xiang-wang-US/Combat_Robot/docs/Combat_Robot_Case_Study.pdf

Context

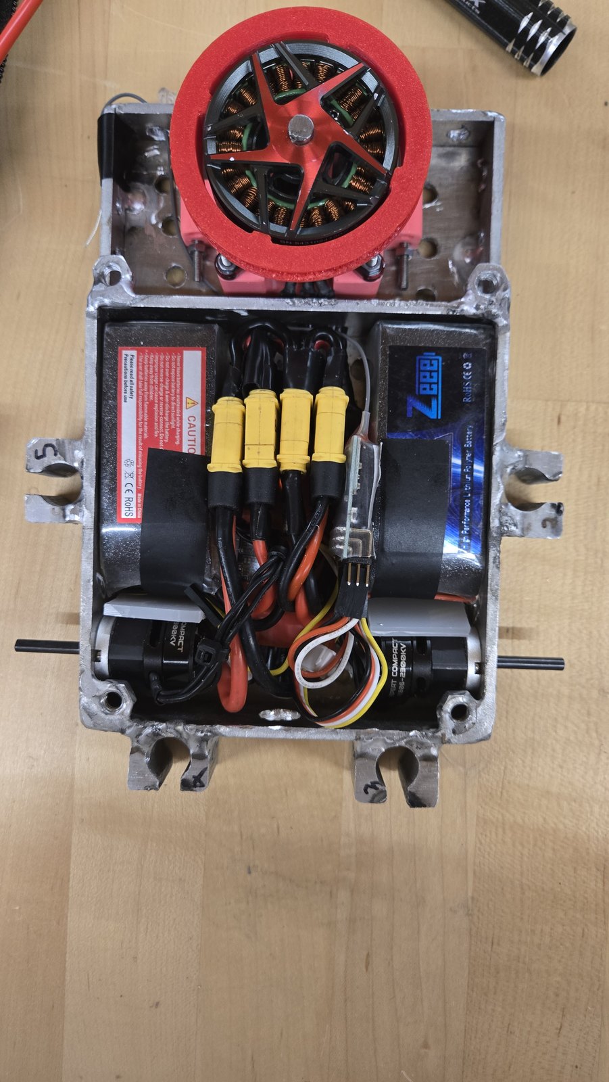
[picture p13: figure]

ASME combat robotics team, Cntrl Alt Defeat

Dates
Fall 2025 to April 2026

My role
Electrical subsystem lead

Scope
Power, motor control, radio,

weapon and chassis analysis

Tools
SolidWorks mass properties,

Desmos, wiring design

Outcome
2nd of 16 teams

# 6 lb Combat Robot

Electrical lead for a 6 lb spinner that placed 2nd

of 16 teams. Power, motor control, radio, and the

analysis behind the weapon and chassis.

I owned the electrical system of a 6 lb combat robot:

battery architecture, weapon and drive motor control,

radio, and the harness. I also wrote the two analyses

that shaped the weapon and the chassis: an energy

based speed requirement for the weapon motor and

an assessment that ruled out an all TPU chassis. The

robot placed 2nd of 16.

2nd

of 16 teams
22.2 V

weapon bus from two 3S packs in series

## about 6,000 rpm

weapon speed needed for 500 J

Project

### 6 lb Combat Robot

Sheet title
Overview

Engineer
Xiang Wang

Date
2025 to 2026

Sheet

# Electrical architecture

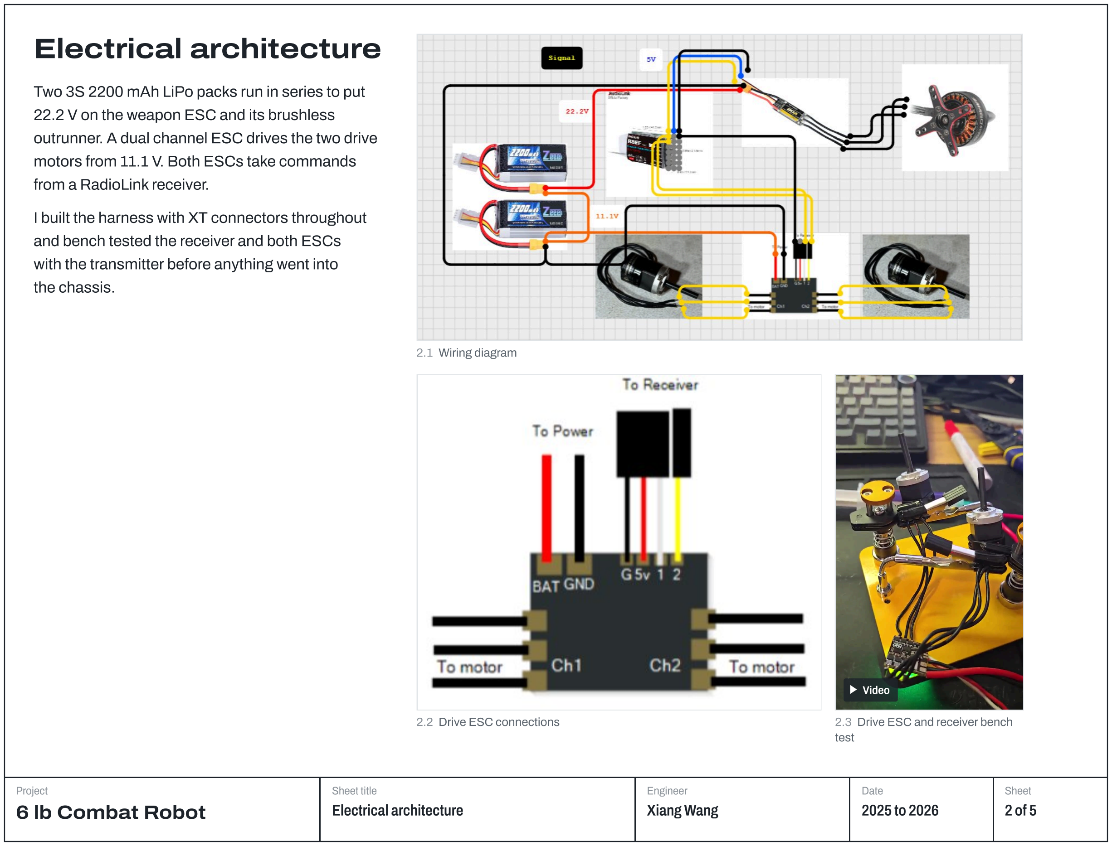
[picture p14: page 2]

Two 3S 2200 mAh LiPo packs run in series to put

22.2 V on the weapon ESC and its brushless

outrunner. A dual channel ESC drives the two drive

motors from 11.1 V. Both ESCs take commands

from a RadioLink receiver.

I built the harness with XT connectors throughout

and bench tested the receiver and both ESCs

with the transmitter before anything went into

the chassis.

2.1 Wiring diagram

2.2 Drive ESC connections | 2.3 Drive ESC and receiver bench
| test

Project

Sheet title
Electrical architecture

Engineer
Date

Sheet

Video (https://github.com/xiang-wang-US/Combat_Robot/blob/main/media/video/bot_esc_test.mp4)

# Weapon speed requirement

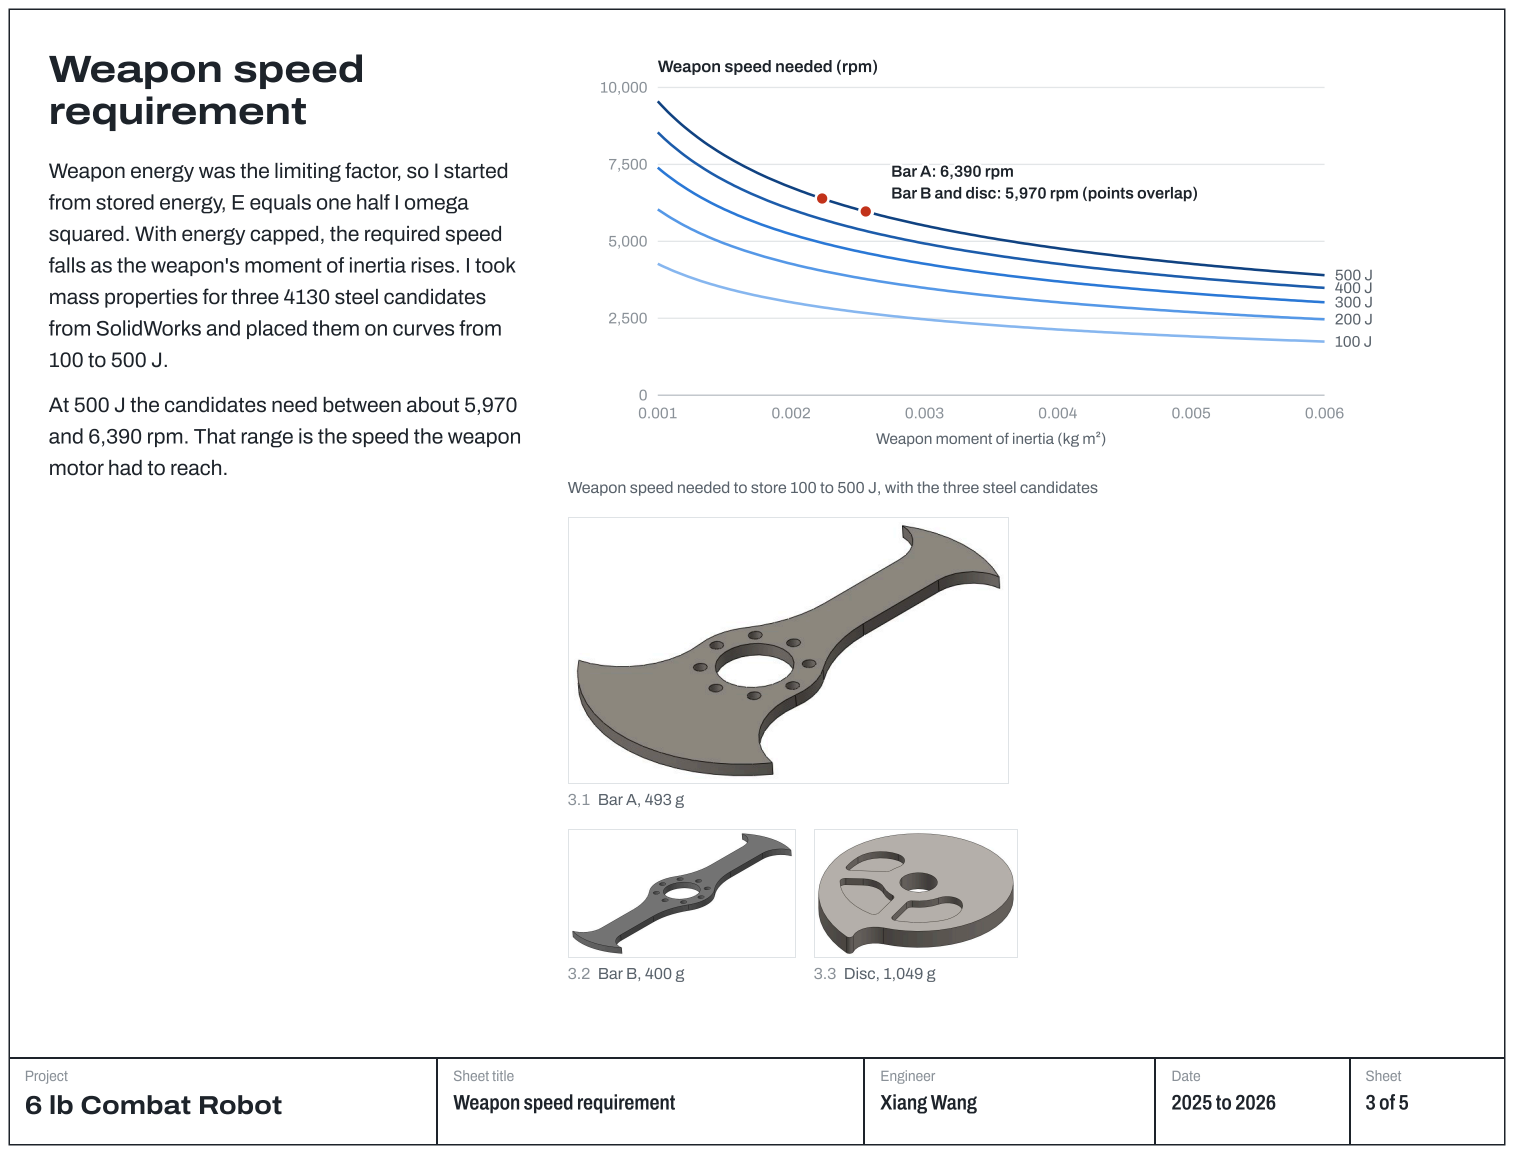
[picture p15: page 3]
3.1 Bar A, 493 g; 3.2 Bar B, 400 g; 3.3 Disc, 1,049 g; Project; Engineer; Date; Sheet

Weapon speed needed (rpm)

Weapon energy was the limiting factor, so I started

Bar A: 6,390 rpm

from stored energy, E equals one half I omega

Bar B and disc: 5,970 rpm (points overlap)

squared. With energy capped, the required speed

falls as the weapon's moment of inertia rises. I took

mass properties for three 4130 steel candidates

from SolidWorks and placed them on curves from

At 500 J the candidates need between about 5,970

and 6,390 rpm. That range is the speed the weapon

Weapon moment of inertia (kg m²)

motor had to reach.

Weapon speed needed to store 100 to 500 J, with the three steel candidates

Sheet title
Weapon speed requirement

# Chassis material assessment

A TPU only chassis was proposed for its impact

absorption. I wrote an assessment arguing against

it. TPU's modulus is roughly 10 to 100 MPa against

about 70 GPa for aluminum, so a TPU frame flexes

enough to misalign shafts and weapon mounts. It

also creeps under sustained load, lets threaded

inserts pull out under shock, and softens near 80 to

100 C, which motors and ESCs can reach.

The recommendation was a rigid structure with TPU

only where it helps: bumpers, electronics mounts,

and abrasion covers. The final robot used an

aluminum chassis.


4.1 Aluminum chassis during fabrication | 4.2 Drive and weapon electronics on the
| bench

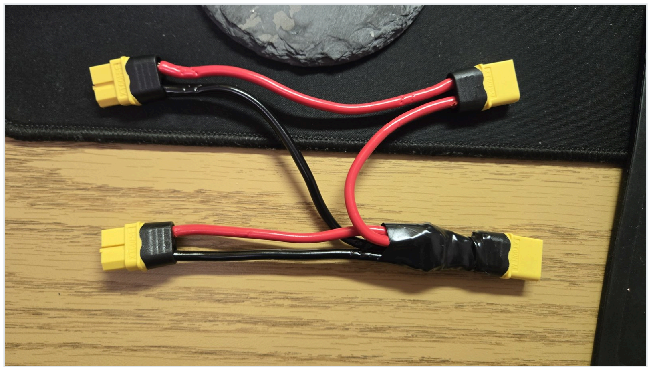
[picture p16: figure]

4.3 Series harness for the weapon packs

Project

Sheet title
Chassis material assessment

Engineer
Date

Sheet

# Testing and competition

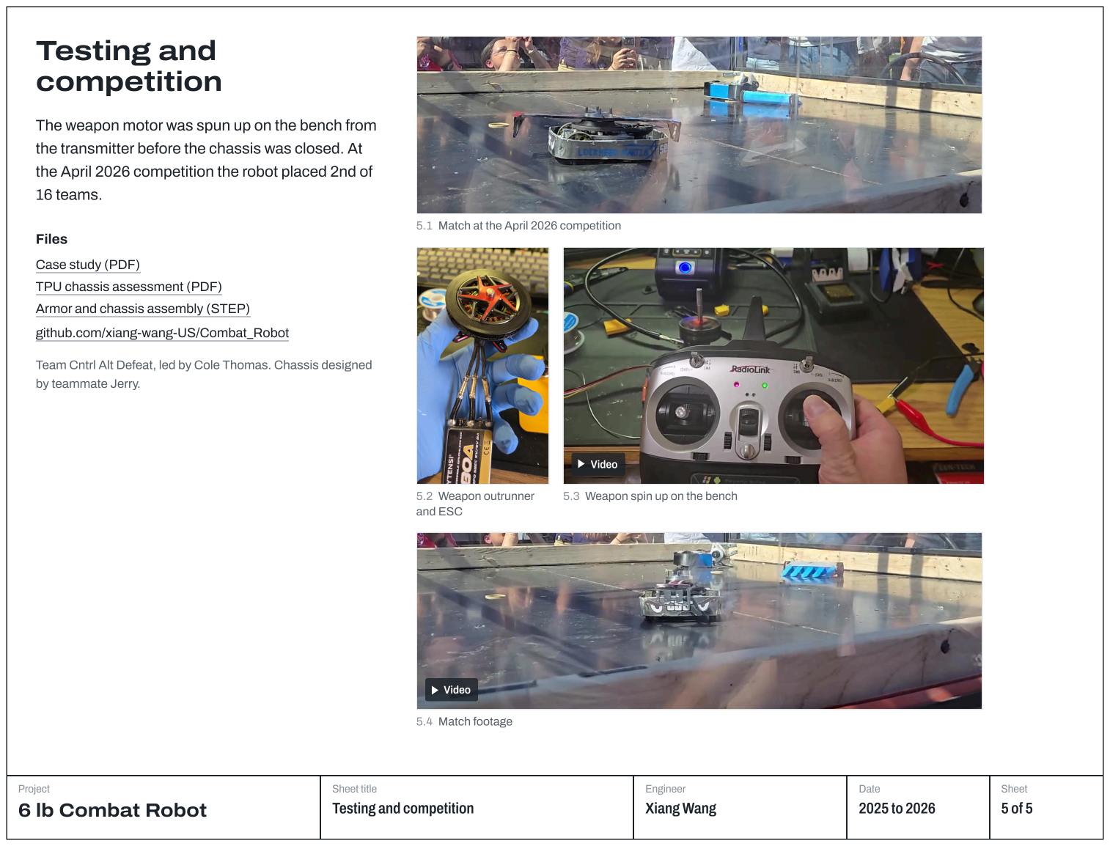
[picture p17: page 5]
16 teams.; Files; 5.2 Weapon outrunner; and ESC; 5.4 Match footage; Project; Engineer; Date; Sheet; Video

The weapon motor was spun up on the bench from

the transmitter before the chassis was closed. At

the April 2026 competition the robot placed 2nd of

5.1 Match at the April 2026 competition

Case study (PDF) (https://github.com/xiang-wang-US/Combat_Robot/blob/main/docs/Combat_Robot_Case_Study.pdf)

TPU chassis assessment (PDF) (https://github.com/xiang-wang-US/Combat_Robot/blob/main/docs/TPU_Chassis_Assessment.pdf)

Armor and chassis assembly (STEP) (https://github.com/xiang-wang-US/Combat_Robot/blob/main/cad/Armor_Assembly.step)

github.com/xiang-wang-US/Combat_Robot

Team Cntrl Alt Defeat, led by Cole Thomas. Chassis designed

by teammate Jerry.

5.3 Weapon spin up on the bench

Sheet title
Testing and competition
