xiang-wang-US/Combat_Robot/cad/Armor_Assembly.step

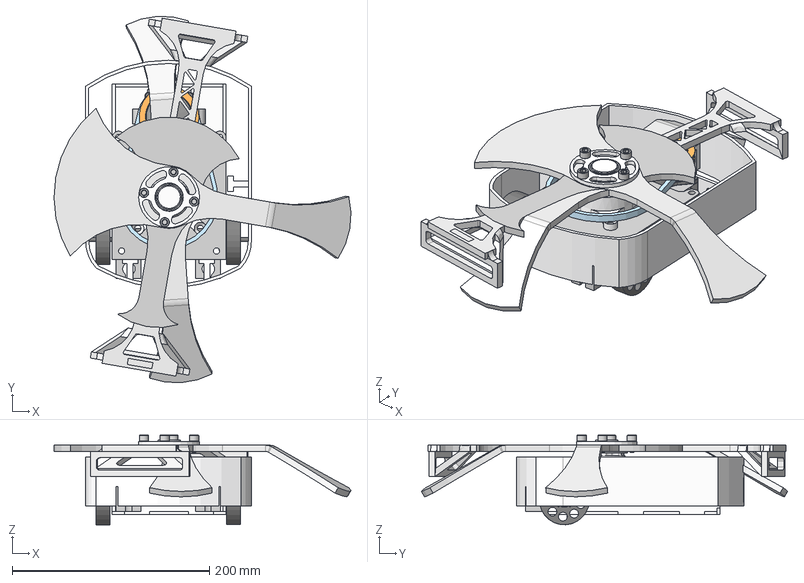
[picture p18: CAD file, 2026-10-12]
cad/Armor_Assembly.step
301.5 x 371.8 x 90.9 mm
Armor Design GS
T-MOTOR AM480
Battery x 2
60355K291_Ball Bearing
60355K604_Ball Bearing
91864A062_Black-Oxide Alloy Steel Socket Head Screw x 4
sheet metal
Weapon ESC
PCB
PDFN3333 (DFN8 3.3x3.3) x 12
SOT23-5 x 3
WE_Inductor_4020
TPS51385
Yageo-RC1218 x 2
ceramic_cap_0805 v1 x 14
GMP22____^GMP22-22_Repeat_Compact(2)_Repeat_Compact x 2
MR84ZZ____^GMP22-22_Repeat_Compact(2)_Repeat_Compact x 4
^GMP22-22_Repeat_Compact(2)_Repeat_Compact x 2
Copy (2) of ^GMP22-22_Repeat_Compact(2)_Repeat_Compact x 2
Copy (3) of ^GMP22-22_Repeat_Compact(2)_Repeat_Compact x 2
________10.4_M0^GMP22-22_Repeat_Compact(2)_Repeat_Compact x 2
^BL 1806 2300KV 2-3S_Repeat_Compact(2)_Repeat_Compact x 2
Copy (2) of ^BL 1806 2300KV 2-3S_Repeat_Compact(2)_Repeat_Compact x 2
Copy (3) of ^BL 1806 2300KV 2-3S_Repeat_Compact(2)_Repeat_Compact x 2
Copy (4) of ^BL 1806 2300KV 2-3S_Repeat_Compact(2)_Repeat_Compact x 2
Butt^BL 1806 2300KV 2-3S_Repeat_Compact(2)_Repeat_Compact x 2
Shaft 2mm^BL 1806 2300KV 2-3S_Repeat_Compact(2)_Repeat_Compact x 2
Copy (5) of ^BL 1806 2300KV 2-3S_Repeat_Compact(2)_Repeat_Compact x 2
Copy (6) of ^BL 1806 2300KV 2-3S_Repeat_Compact(2)_Repeat_Compact x 2
Copy (7) of ^BL 1806 2300KV 2-3S_Repeat_Compact(2)_Repeat_Compact x 2
Copy (8) of ^BL 1806 2300KV 2-3S_Repeat_Compact(2)_Repeat_Compact x 2
Copy (9) of ^BL 1806 2300KV 2-3S_Repeat_Compact(2)_Repeat_Compact x 2
Copy (10) of ^BL 1806 2300KV 2-3S_Repeat_Compact(2)_Repeat_Compact x 2
Copy (11) of ^BL 1806 2300KV 2-3S_Repeat_Compact(2)_Repeat_Compact x 2
Copy (12) of ^BL 1806 2300KV 2-3S_Repeat_Compact(2)_Repeat_Compact x 2
Copy (13) of ^BL 1806 2300KV 2-3S_Repeat_Compact(2)_Repeat_Compact x 2
Copy (14) of ^BL 1806 2300KV 2-3S_Repeat_Compact(2)_Repeat_Compact x 2
Copy (15) of ^BL 1806 2300KV 2-3S_Repeat_Compact(2)_Repeat_Compact x 2
Copy (16) of ^BL 1806 2300KV 2-3S_Repeat_Compact(2)_Repeat_Compact x 2
Copy (17) of ^BL 1806 2300KV 2-3S_Repeat_Compact(2)_Repeat_Compact x 2
Copy (18) of ^BL 1806 2300KV 2-3S_Repeat_Compact(2)_Repeat_Compact x 2
Copy (19) of ^BL 1806 2300KV 2-3S_Repeat_Compact(2)_Repeat_Compact x 2
Copy (20) of ^BL 1806 2300KV 2-3S_Repeat_Compact(2)_Repeat_Compact x 2
Copy (21) of ^BL 1806 2300KV 2-3S_Repeat_Compact(2)_Repeat_Compact x 2
Copy (22) of ^BL 1806 2300KV 2-3S_Repeat_Compact(2)_Repeat_Compact x 2
Copy (23) of ^BL 1806 2300KV 2-3S_Repeat_Compact(2)_Repeat_Compact x 2
Copy (24) of ^BL 1806 2300KV 2-3S_Repeat_Compact(2)_Repeat_Compact x 2
Copy (25) of ^BL 1806 2300KV 2-3S_Repeat_Compact(2)_Repeat_Compact x 2
Copy (26) of ^BL 1806 2300KV 2-3S_Repeat_Compact(2)_Repeat_Compact x 2
Copy (27) of ^BL 1806 2300KV 2-3S_Repeat_Compact(2)_Repeat_Compact x 2
Copy (28) of ^BL 1806 2300KV 2-3S_Repeat_Compact(2)_Repeat_Compact x 2
Copy (29) of ^BL 1806 2300KV 2-3S_Repeat_Compact(2)_Repeat_Compact x 2
Copy (30) of ^BL 1806 2300KV 2-3S_Repeat_Compact(2)_Repeat_Compact x 2
Copy (31) of ^BL 1806 2300KV 2-3S_Repeat_Compact(2)_Repeat_Compact x 2
Copy (32) of ^BL 1806 2300KV 2-3S_Repeat_Compact(2)_Repeat_Compact x 2
Copy (33) of ^BL 1806 2300KV 2-3S_Repeat_Compact(2)_Repeat_Compact x 2
Copy (34) of ^BL 1806 2300KV 2-3S_Repeat_Compact(2)_Repeat_Compact x 2
Copy (35) of ^BL 1806 2300KV 2-3S_Repeat_Compact(2)_Repeat_Compact x 2
Copy (36) of ^BL 1806 2300KV 2-3S_Repeat_Compact(2)_Repeat_Compact x 2
Copy (37) of ^BL 1806 2300KV 2-3S_Repeat_Compact(2)_Repeat_Compact x 2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
